arsenier/nedoROS/docs/hardware/overview.md

# Аппаратная часть

Робот представляет из себя тележку с дифференциальным приводом и волокушей, манипулятором, контроллером Arduino Uno и одноплатным компьютером Raspberry Pi 4B.

## Внешний вид робота

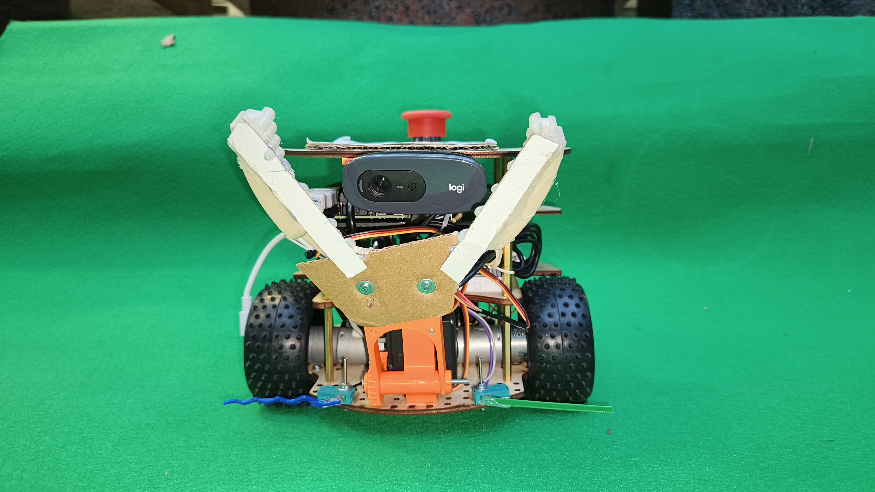
[picture p4: docs/img/robot_front.jpg]

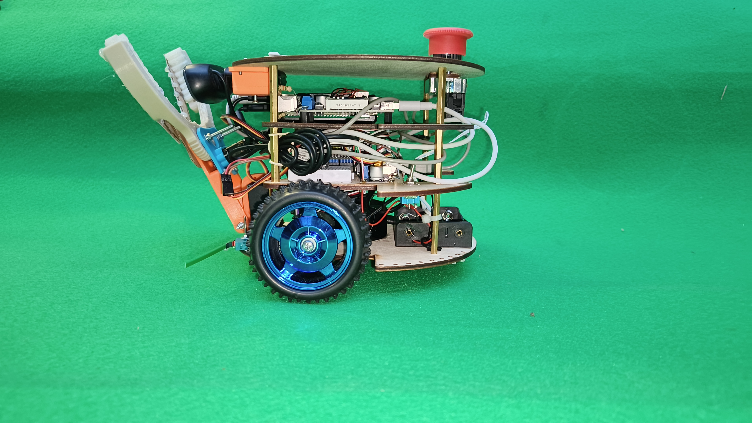
[picture p5: docs/img/robot_left.jpg]

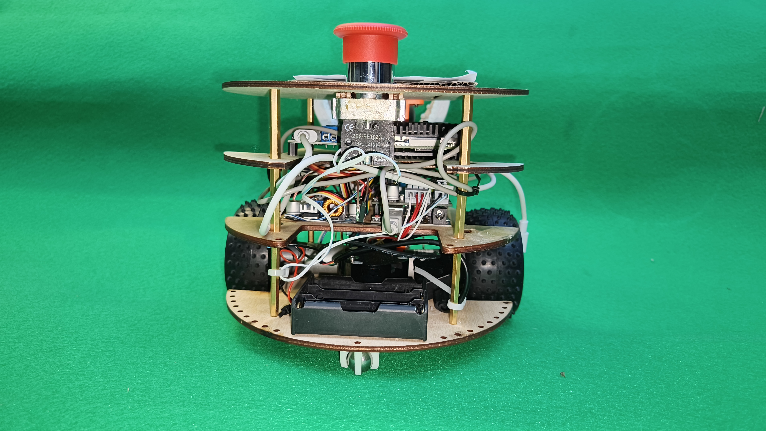
[picture p6: docs/img/robot_back.jpg]

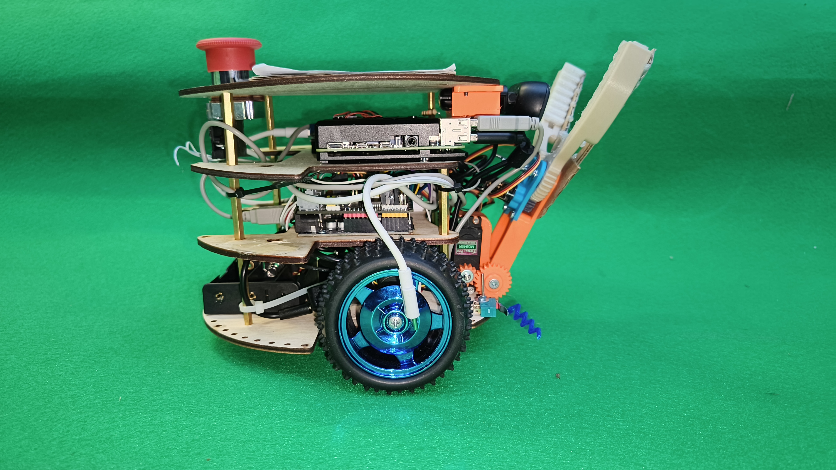
[picture p7: docs/img/robot_right.jpg]

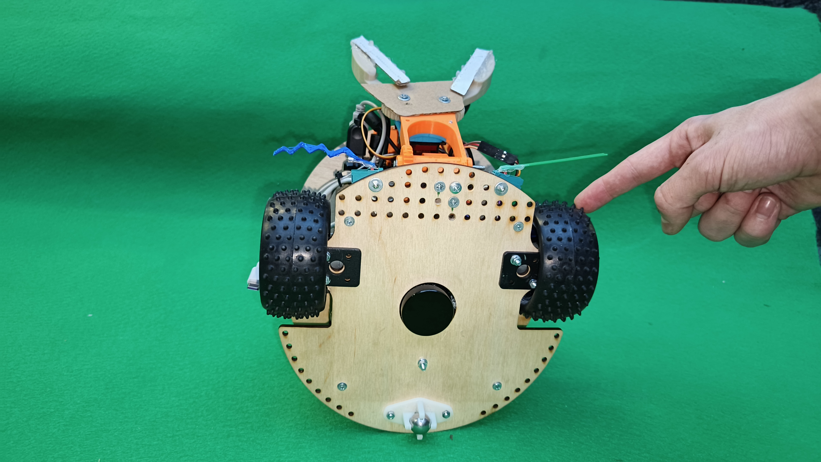
[picture p8: docs/img/robot_bottom.jpg]
