arsenier/nedoROS/docs/hardware.md

# Аппараратная часть

Робот представляет из себя тележку с дифференциальным приводом и волокушей, манипулятором, контроллером Arduino Uno и одноплатным компьютером Raspberry Pi 4B.

## Внешний вид робота







## Аппаратное оснащение

## Список компонентов и ссылок

| Закупки: | Название | Назначение, описание | Прямая ссылка где купить | Количество | Фотография если нужно |
|---|---|---|---|---|---|
| 1 | Raspberry pi 4B | крутиться рос, обработка лидара, общение с ардуино | https://aliexpress.ru/item/1005006733203166.html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 | 1 | |
| 2 | logitech c270 | детект чаруко доски, детект робота, распознование объектов на их местах | https://aliexpress.ru/item/1_326088900.html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 | 1 | |
| 3 | Грибок аварийного выключения | разрыв земли цепи питания | https://www.ozon.ru/product/knopka-avariynoy-ostanovki-gribok-povorotnaya-s-fiksatsiey-ip40-220v-10a-2-kontakta-kruglaya-302434565/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 | 1 | |
| 4 | Ардуино уно | подача сигнала на моторы, считывание IMU, считывание концевиков, управление сервой | https://aliexpress.ru/item/1005004073975153.html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 | 1 | |
| 5 | Шилд мотора | вольтаж с запасо | https://iarduino.ru/shop/Expansion-payments/Motor-Shield-L298.html | | |
| 6 | MG946R | подъем захвата вверх-вниз | https://aliexpress.ru/item/4000502044588.html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 | 1 | |
| 7 | mg90 | управляют схватом захвата. часто горят :( | https://www.ozon.ru/product/2sht-servoprivod-mg90-s-micro-servo-servomotor-mg90s-3-7-2v-ampertok-tower-pro-mg90-180-micro-servo-3539223449/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 | 1 | |
| 8 | интерфейсные провода | малинка(usb-a)- ардуино (usb-b) | | 1 | |
| 9 | лидар | направление объекта для стыковки. | https://aliexpress.ru/item/1005007075882801.html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 | 1 | |
| 10 | тумблер питания | для планового выключения питания | https://aliexpress.ru/item/1005001994328465.html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 | 1 | |
| 11 | LM2596 | стаб 12в-5в на сервочки | https://aliexpress.ru/item/1005003780274326.html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 | 1 | |
| 12 | XL4015 с вольтметром | Смотреть напряжение на банках и питать малинку от юсб | https://market.yandex.ru/cc/975WaF | 1 | |
| 13 | пищалка | сигнализация о разряде банок | https://aliexpress.ru/item/1005008750369827.html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 | 1 | |
| 14 | отсек для аккумуляторов | | https://aliexpress.ru/item/1005004036301580.html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 | 1 | |
| 15 | концевик | усиками детектить попадания в себя противников | https://aliexpress.ru/item/1005008634065991.html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 | 2 | |
| 16 | колеса 85мм | кататься | https://ardmag.ru/mehanics/wheels/1674.html | 2 | |
| 17 | dc мотор, 12вольт + наколхозить крепеж | кататься | aliexpress.ru/item/32855724293.html?sku_id=12000041529946492&spm=a2g2w.productlist.search_results.4.61f341acMpGT7g | 2 | |
| 18 | муфта для крепежа колеса на вал мотора | шестигранник 2.0 | https://aliexpress.ru/item/1005010112043572.html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 | 2 | |
| 19 | макетные провода всех типов | | | | |
| 20 | резисторы для делителя | | | | |
