arsenier/nedoROS/docs/software/nav_level.md

# Сервер GPS и классификация объектов

### [Видео с демонстрацией работы GPS и классификации объектов](./img/video_demo.webm)



## Общая схема
```
┌──────────── Изображение с камеры
│               │              │
│               ▼              ▼
│  ┌───────────────────┐ ┌───────────────────┐
│  │Определение позиции│ │Определение позиции│
│  │   charuco-доски   │ │   aruco-маркера   │
│  └────┬───────┬──────┘ └────┬──────────────┘
│       │       │             │  
│       │       ▼             ▼
│       │     ┌──────────────────┐
│       │     │Вычисление позиции│
│       │     │ маркера на доске │
│       │     └──────────────────┘
│       │               │
│       │               ▼
│       │      Отправка на робота
▼       ▼
┌───────────────────┐
│"Выпрямление" доски│
│ по известной поз. │
└───────────────────┘
         │
         ▼
┌───────────────────┐
│  Определение  16  │
│ стартовых позиций │
└───────────────────┘
         │
         ▼
┌───────────────────┐
│Определение объекта│
│    в  каждой из   │
│ стартовых позиций │
└───────────────────┘
         │
         ▼
 Отправка на робота
```

## Запуск

Для удобного запуска реализован launch-файл [all.launch.py](https://github.com/arsenier/nedoROS/blob/main/charuco_ws/src/nedo_bringup/launch/all.launch.py), который запускает:

- `usb_cam_node_exe` для получения изображения с камеры
- `charuco_detector` для распознавания и получения координат доски
- `apriltag_pose_detector_node` для распознавания и получения координат маркера
- `pose_recalibrator` для получения координат маркера в относительных координатах доски
- `charuco_rectifier_node` для "выпрямления" доски по известной позиции и распознавания объектов

В этом же файле находятся все основные настройки, например параметры aruco-маркера, названия топиков и т.д.

## usb_cam_node_exe

Используется стандартный usb_cam для получения изображения с камеры, которое отправляется в топик `/image_raw`. Также для корректной работы нод камера была откалибрована, и данные о ней передаются в топик `/camera_info`.

В папке [charuco_ws/src/usb_cam](https://github.com/arsenier/nedoROS/blob/main/charuco_ws/src/usb_cam) находятся файлы с настройками камеры. Там важно изменить все параметры камеры под свою, а также полезно настроить яркость (brightness) до сборки датасета и использования распознавания объектов.

## charuco_detector

Нода определяет арукомаркеры на изображении и по их позициям, зная искажение камеры и расположение маркеров на доске, определяет позицию доски относительно камеры. Публикует tf2 топик `/image_raw_charuco_pose` с координатами доски относительно координат камеры.

За основу взят репозиторий [charuco_detector_ROS2](https://github.com/errrr0501/charuco_detector_ROS2), портировавший на ROS2 репозиторий [charuco_detector](https://github.com/carlosmccosta/charuco_detector).

## apriltag_pose_detector_node

Нода определяет все маркеры на изображении. Она используется для получения координат робота (с маркером 239 семейства Aruco 250_4х4) и распознавания центрального маркера для определения старта игры.

Получение координат маркера в системе камеры аналогично получению координат charuco-доски. Код представляет собой стандартный пример обнаружения маркеров библиотеки OpenCV2, обернутый в ROS2.

## pose_recalibrator

Нода получает tf2-топики `/image_raw_charuco_pose` и `/image_raw_apriltag_pose` и вычисляет координаты маркера в координатах доски, включая координаты центра маркера и его направление, то есть направление взгляда робота. Преобразование делается стандартным ROS2-методом для tf2.

Полученные координаты отправляются на робота через топик `/image_recalib_apriltag_pose`.

## charuco_rectifier_node

Нода получает изображение с камеры, откалиброванные параметры камеры (типа искажения, разрешения и т.д.) и позицию доски относительно камеры. Используя эти данные, мы можем определить позиции углов доски в пикселях на изображении и по ним "выпрямить" доску, то есть получить прямоугольное изображение, углы которого соответствуют углам доски, а расстояние в пикселях соответствует расстоянию в миллиметрах на реальной доске.

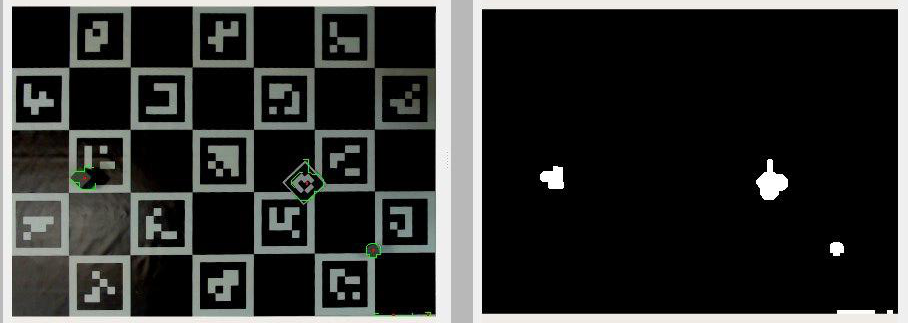
[picture p17: docs/software/img/rectified_board.jpg]
charuco_rectifier_node


Так как мы точно знаем стартовые позиции объектов, мы можем получить изображения каждого из них, обрезая матрицу изображения с выровненной доской.

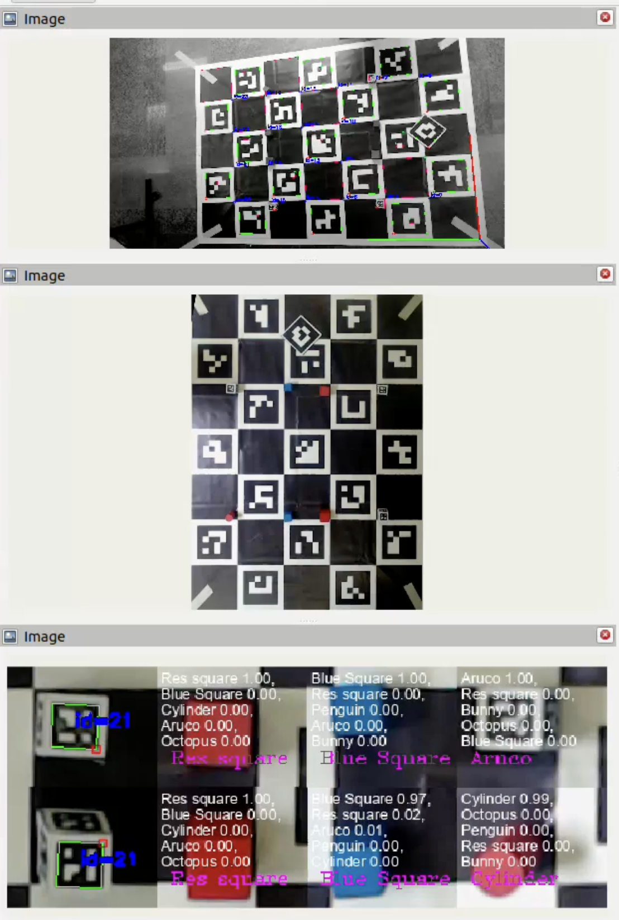
[picture p18: docs/software/img/rviz_final.png]
rviz_debug


Это скрин отладочных выводов в RViz. Здесь видно, как нарезаются картинки для каждого объекта, которые по одной передаются в модуль распознавания (подробнее [тут](./duck_classifier.md)), который определяет тип и возвращает его нам.

Код определяет все 16 объектов. Если симметричные объекты совпадают (по регламенту расположение объектов симметрично в начале матча), значит вероятность ошибки мала, и код отправляет на робота список, сопоставляющий номер позиции на поле с объектом, который там стоит. Когда центральный тег открывается в начале игры и запуска роботов, мы больше не распознаем объекты и отправляем последний список, который увидели.

## Классификация объектов

<!-- https://superuser.com/a/556031 -->
<!-- ffmpeg -i dataset.mp4     -vf "fps=15,scale=360:-1:flags=lanczos,split[s0][s1];[s0]palettegen[p];[s1][p]paletteuse"     -loop 0 dataset15360.gif -->

### Сборка датасета



# Apendix

## ___Идеи дальше остались на стадии разработки___

Весь код можно найти в файле [charuco_rectifier_node.py](https://github.com/arsenier/nedoROS/blob/main/charuco_ws/src/charuco_rectifier/charuco_rectifier/charuco_rectifier_node.py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)
Изначально мы планировали определять позиции объектов с камеры над полем, так как думали, что их стартовое расположение будет случайным. Для этого мы сначала калибровались, запоминая изображение поля без объектов и роботов на нем, уже "выпрямленное". Возьмем такое изображение:

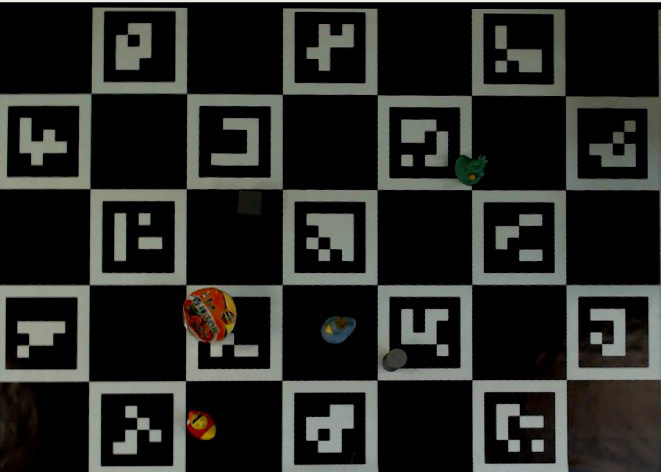
[picture p19: docs/software/img/apendix1.jpeg]


Теперь работаем с картинками как с матрицами: ___вычисляем модуль разности для каждого пикселя___ между калибровочным изображением и картинкой с поля. Если вывести полученную матрицу, получим следующее:

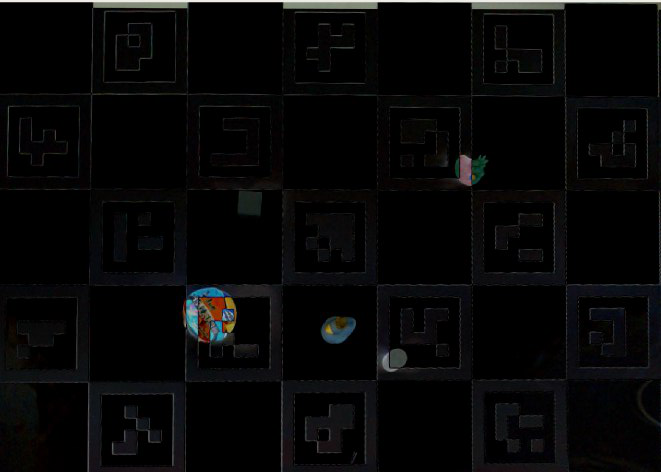
[picture p20: docs/software/img/apendix2.jpeg]


Видно, что рисунок самой доски почти исчезает, что легко исправляется морфологическими преобразованиями, а объекты на полученном изображении легко различимы.

Проблема в том, что такая разность слишком чувствительна к изменениям освещения, особенно к теням на поле. Из-за этого приходится сильно обрабатывать полученную матрицу, хотя даже в таком виде из нее можно получить хорошую маску хотя бы в тепличных условиях.

charuco_rectifier_node

Первое большое пятно - это наш робот, и его легко убрать, зная его координаты. Второе большое пятно - робот противника; его и объекты с небольшим запасом вокруг тоже можно исключить. Все, что останется, будет соответствовать игровым объектам. Зная их точные позиции на изображении, можно обрезать кадр и отправить его в модуль распознавания, как описано выше.

### Планирование маршрута с объездом препятствий

В той же ноде [charuco_rectifier_node](https://github.com/arsenier/nedoROS/blob/main/charuco_ws/src/charuco_rectifier/charuco_rectifier/charuco_rectifier_node.py) планировалось составлять маршрут для робота с объездом дешевых объектов и вражеского робота. Но, увидев регламент самого хакатона, мы решили просто доставлять в зону выгрузки ближайшие объекты, отдавая приоритет более дорогим.

На взаимодействие с противником мы не рассчитывали, но на всякий случай оставили "усики", которые не дают роботу таранить объекты. Подробнее об этом можно прочитать в разделе про аппаратную часть.
