arsenier/nedoROS/rpi_ws/workspace/all_launch.py

#!/usr/bin/python3
from ament_index_python.packages import get_package_share_directory
from launch import LaunchDescription
from launch_ros.actions import LifecycleNode
from launch.substitutions import LaunchConfiguration
from launch_ros.actions import Node
from launch.actions import DeclareLaunchArgument

import lifecycle_msgs.msg
import os

def generate_launch_description():

    driver_dir = os.path.join(get_package_share_directory('lslidar_driver'), 'params', 'lsx10.yaml')
                     
    driver_node = LifecycleNode(package='lslidar_driver',
                                executable='lslidar_driver_node',
                                name='lslidar_driver_node',		#设置激光数据topic名称
                                output='screen',
                                emulate_tty=True,
                                namespace='',
                                parameters=[driver_dir],
                                )

    tf2_node = Node(package='tf2_ros',
                    executable='static_transform_publisher',
                    name='static_tf_pub_laser',
                    arguments=['0', '0', '0.02','1', '-0.9', '0', '0','base_link','laser_link'],
                    )

    pi_driver_node = Node(package='pi_driver',
                    executable='pi_driver',
                    name='pi_driver',
                    )

    # usb_cam_node = Node(
    #                         package='usb_cam',
    #                         executable='usb_cam_node_exe',
    #                         name='usb_cam',
    #                         output='screen',
    #                         parameters=[usb_cam_params],
    #                     ),

    

    return LaunchDescription([
        driver_node,
        tf2_node,
        pi_driver_node
    ])
