arsenier/nedoROS/(commit log)

2026-02-02 регулятор скорости и серва
2026-02-02 перенесла часть с гироскопом из кода в код
2026-02-05 add debugging prints (ALL WORKS WITH FILES)
2026-02-05 общение и одометрия
2026-02-09 связь с нодой работает + доработана одометрия
2026-02-19 haha ukral code
    [calibration.yaml]
2026-03-03 good calibrated version
2026-03-05 add example for detect pose on board
2026-03-05 add /map topic with odometry
2026-03-09 calibrate with first frame
2026-03-09 easy calibration
2026-03-09 arduino firmware organized
2026-03-09 renamed folder
    [calibration.yaml]
2026-03-12 fixed velostim and speed regul
    [firmware.ino, motor.ino, velest.ino]
2026-03-12 si ros driver
2026-03-12 removed prints
2026-03-12 lidar tf and si navigation
2026-03-15 new frimware + test servo
2026-03-18 начало маршрутизации
2026-03-18 МЕГАКОММИТ
2026-03-19 arduino firmware: await start and weaker motor PID
2026-03-20 added 90sec timer
2026-03-20 t2 in frimware arduino
2026-03-21 pi driver fix
2026-03-21 servo down
2026-03-22 lidar fix
2026-03-22 lidar fix wip
2026-03-22 Revert "lidar fix"
    This reverts commit d0978aa791f4eddf89832affa7726cb77378f76a.
2026-04-02 Э3 + описание electronic
